hugo-trivino/VLSI/(list of files, drawings)

Other design files:
Intermediate_Results_and_Libraries/shm.db/shm.db.dsn
